DevarshiBohra/CLICKY-Matchbox-Camera/images/7.jpeg

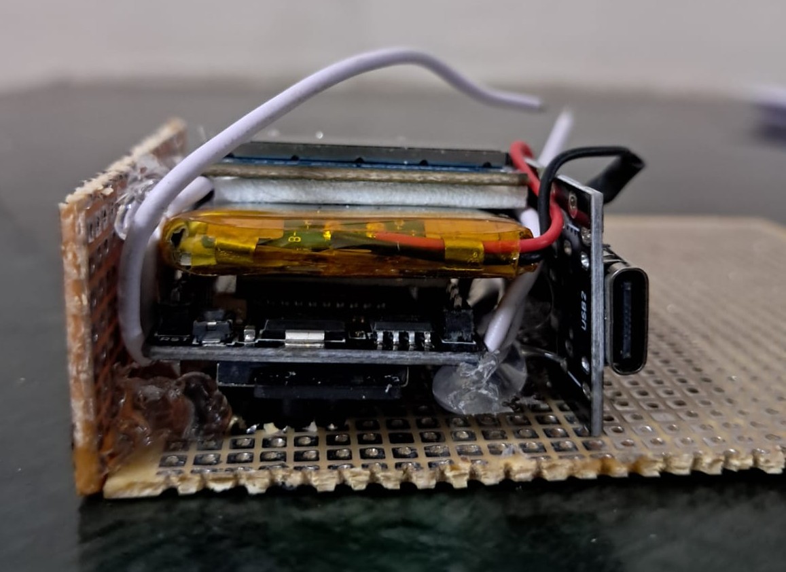
images/7.jpeg
