DevarshiBohra/CLICKY-Matchbox-Camera/(commit log)

2026-04-30 Revise README for prototype images and warnings
    Updated the README to reflect the addition of prototype images and included a note on breadboard prototyping.
2026-05-19 Update image size in README for ESP32-CAM section
    Reduced image display size for ESP32-CAM documentation.
2026-06-30 Add video recording section and update button instructions
    Updated README to include video recording instructions and clarify button press durations.
2026-07-24 Fix formatting in wiring guide section
2026-10-30 Revise GPIO pin mappings and button wiring details
    Updated GPIO pin assignments and clarified button wiring instructions in the README.
2026-10-30 Remove GPIO 4 flash LED note from README
    Removed note about GPIO 4 and its use with the onboard flash LED.
